schmelly/Mendel90/schmelly/bom/bed_assembly.txt

bed_assembly:
Vitamins:
  4 BD0019     19mm bulldog clip
  1 BED214214  PCB bed 214 x 214
  4 CS03010    M3 cap screw x 10
  1 GL3214202  Glass sheet 214 x 202 x 3
  4 HP0320     Hex pillar M3 x 20
  2 WA3075     Washer M3 x 7 x 0.5

Printed:
