schmelly/Mendel90/schmelly/sheets/y_carriage.dxf

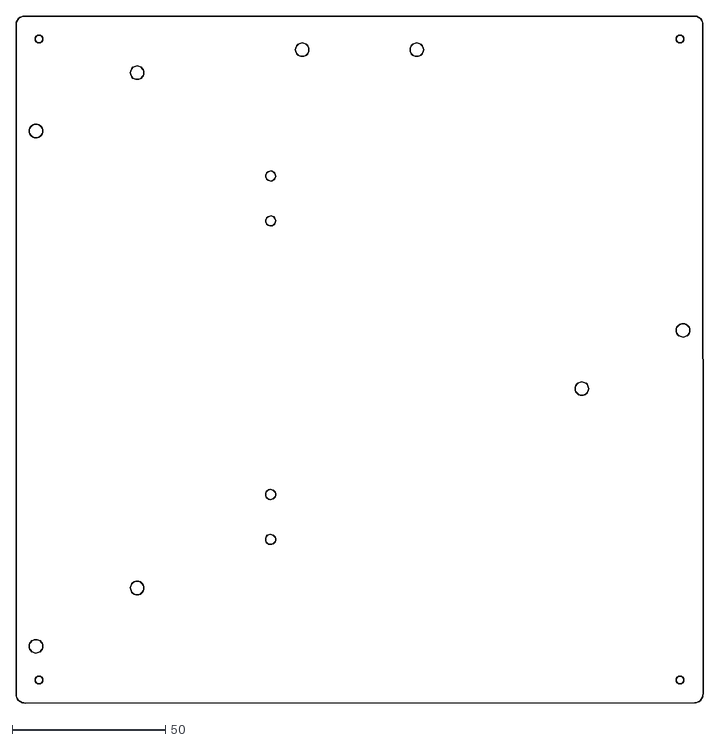
[picture p1: CAD file, 2013-04-06]
schmelly/sheets/y_carriage.dxf
224.0 x 224.0
