schmelly/Mendel90/schmelly/stls/fan_guard.stl

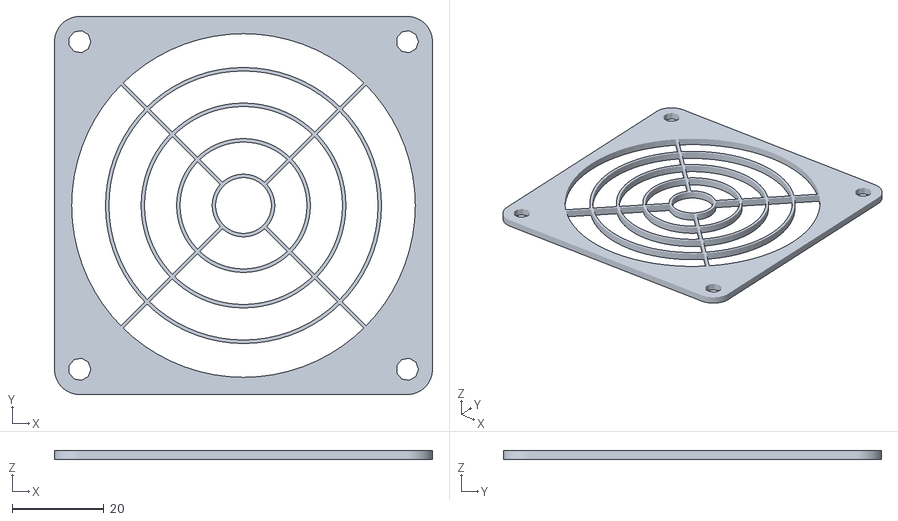
[picture p2: CAD file, 2013-04-06]
schmelly/stls/fan_guard.stl
82.5 x 82.5 x 2.00
