schmelly/Mendel90/schmelly/sheets/frame_gantry.dxf

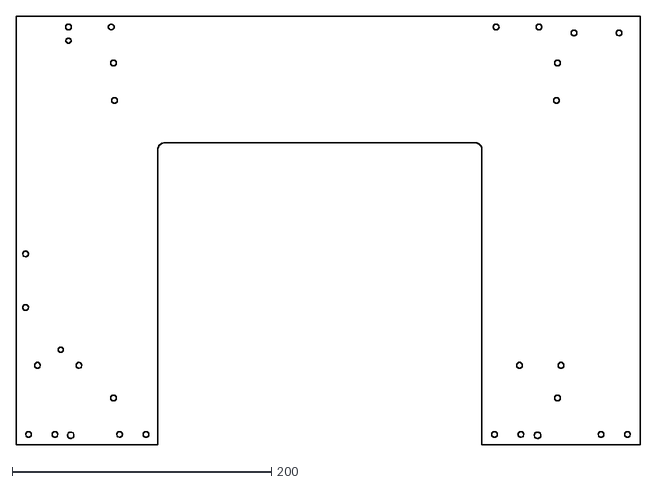
[picture p3: CAD file, 2013-04-06]
schmelly/sheets/frame_gantry.dxf
481.5 x 331.0
