schmelly/Mendel90/schmelly/stls/wades_small_gear.stl

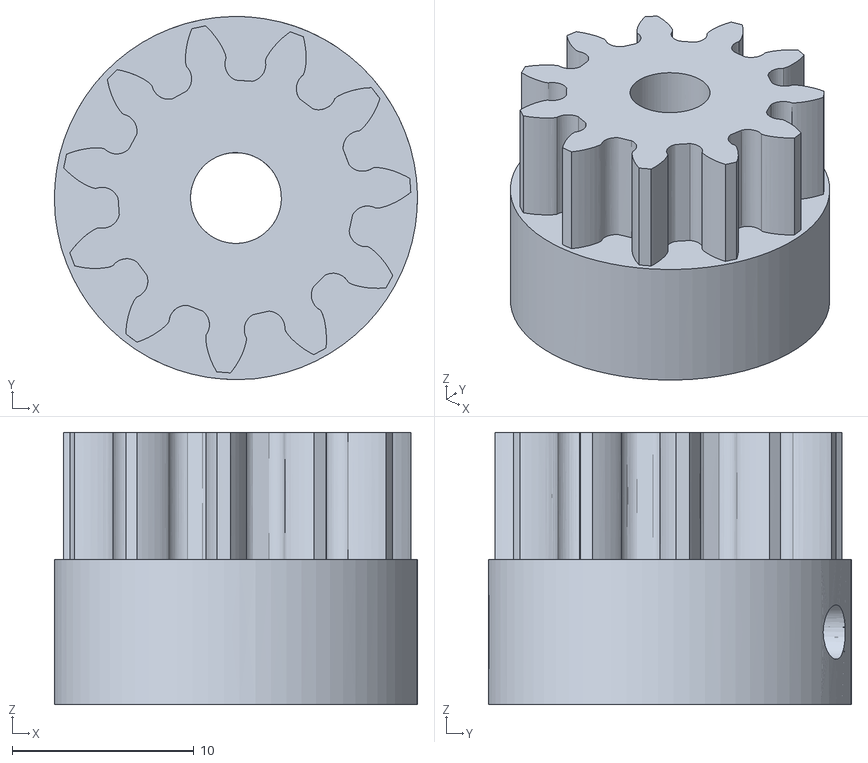
[picture p4: CAD file, 2013-04-06]
schmelly/stls/wades_small_gear.stl
20.0 x 20.0 x 15.0
