schmelly/Mendel90/schmelly/sheets/frame_gantry_and_y_carriage.dxf

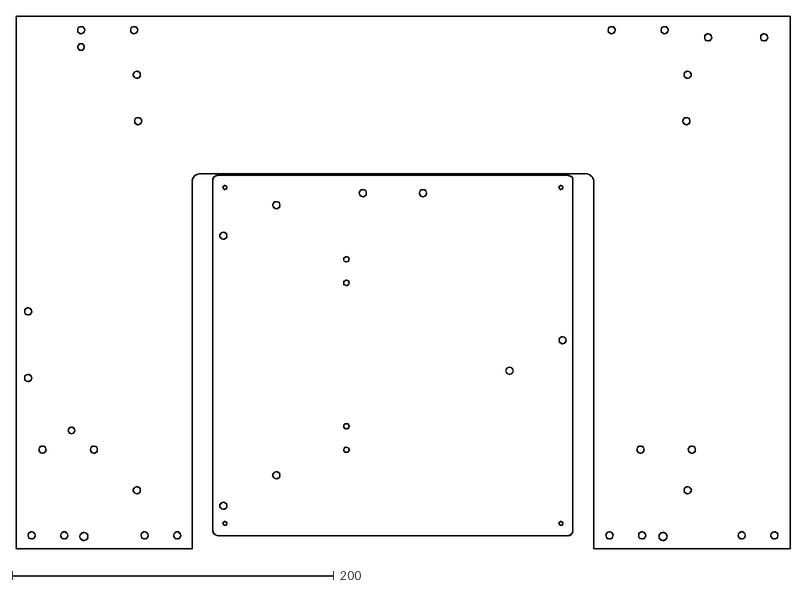
[picture p5: CAD file, 2013-04-06]
schmelly/sheets/frame_gantry_and_y_carriage.dxf
481.5 x 331.0
