schmelly/Mendel90/schmelly/stls/x_motor_bracket.stl

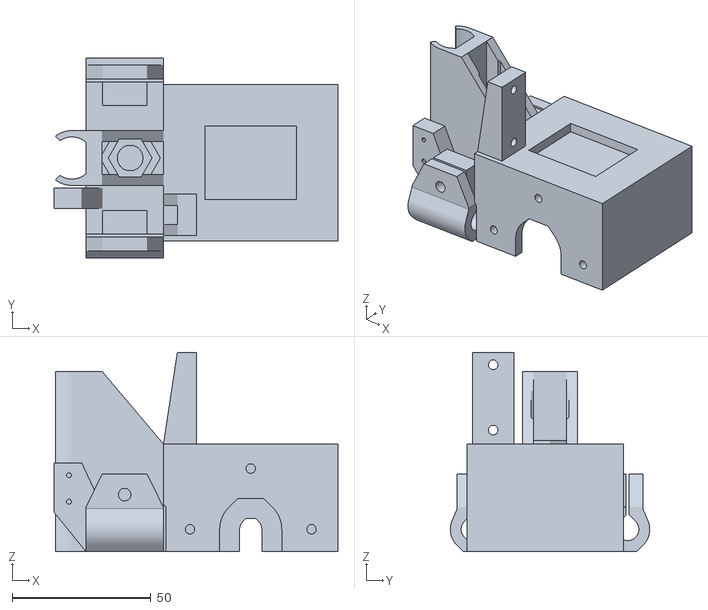
[picture p6: CAD file, 2013-04-06]
schmelly/stls/x_motor_bracket.stl
102.5 x 72.0 x 71.8
