schmelly/Mendel90/schmelly/sheets/frame_base.dxf

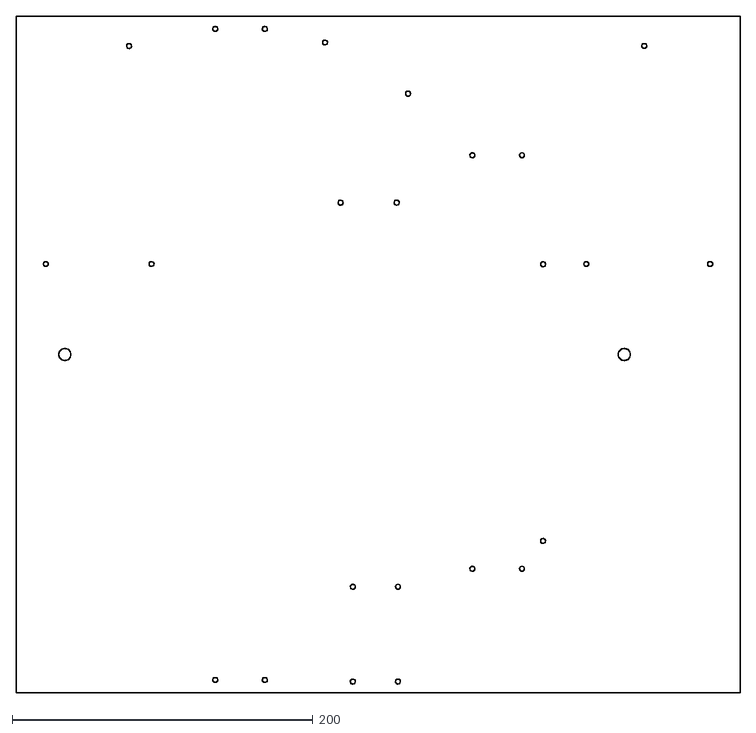
[picture p7: CAD file, 2013-04-06]
schmelly/sheets/frame_base.dxf
481.5 x 450.0
