schmelly/Mendel90/schmelly/stls/x_belt_tensioner.stl

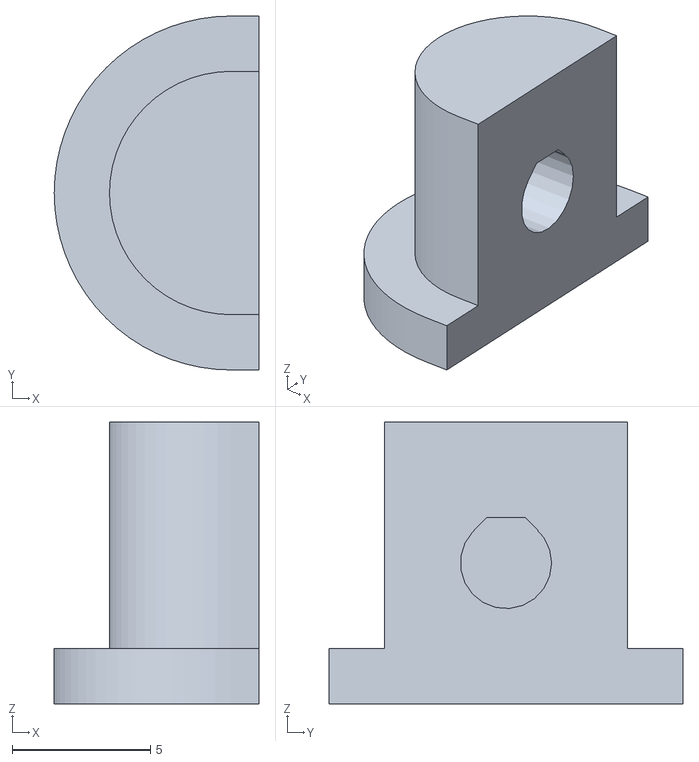
[picture p8: CAD file, 2013-04-06]
schmelly/stls/x_belt_tensioner.stl
7.40 x 12.8 x 10.2
