schmelly/Mendel90/schmelly/sheets/frame_right.dxf

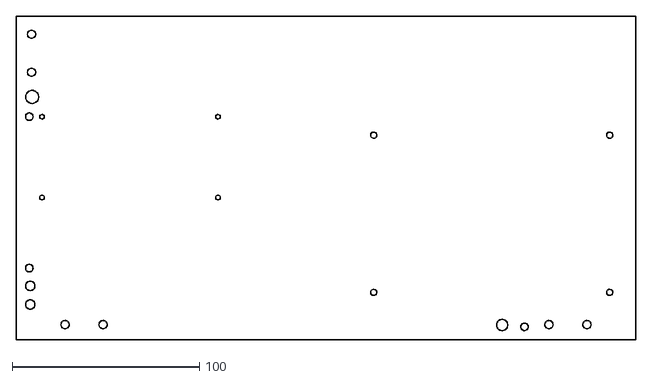
[picture p9: CAD file, 2013-04-06]
schmelly/sheets/frame_right.dxf
331.0 x 173.0
