schmelly/Mendel90/schmelly/stls/ribbon_clamp_20_44.stl

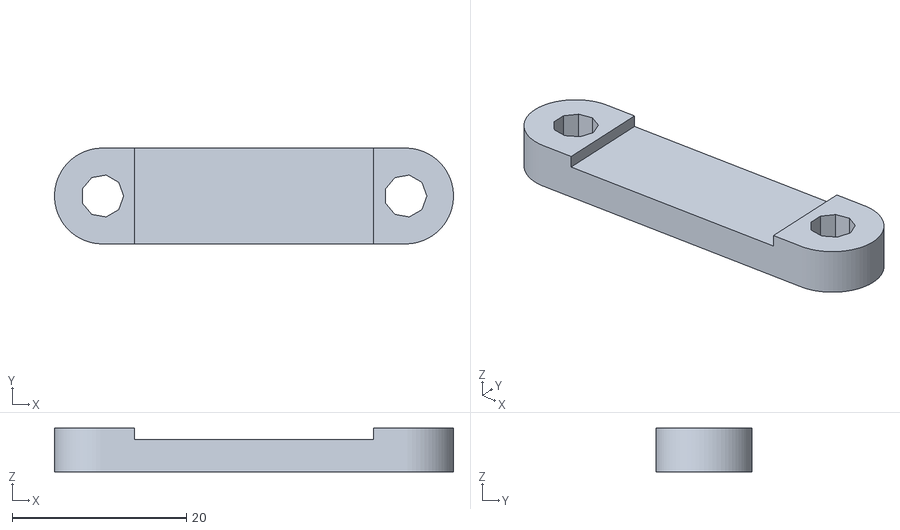
[picture p10: CAD file, 2013-04-06]
schmelly/stls/ribbon_clamp_20_44.stl
45.8 x 11.0 x 5.00
