schmelly/Mendel90/schmelly/sheets/frame_left.dxf

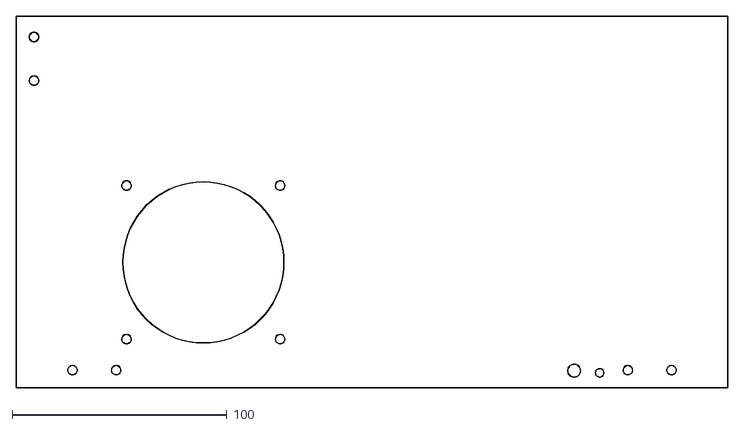
[picture p11: CAD file, 2013-04-06]
schmelly/sheets/frame_left.dxf
331.0 x 173.0
