schmelly/Mendel90/schmelly/stls/y_belt_anchor.stl

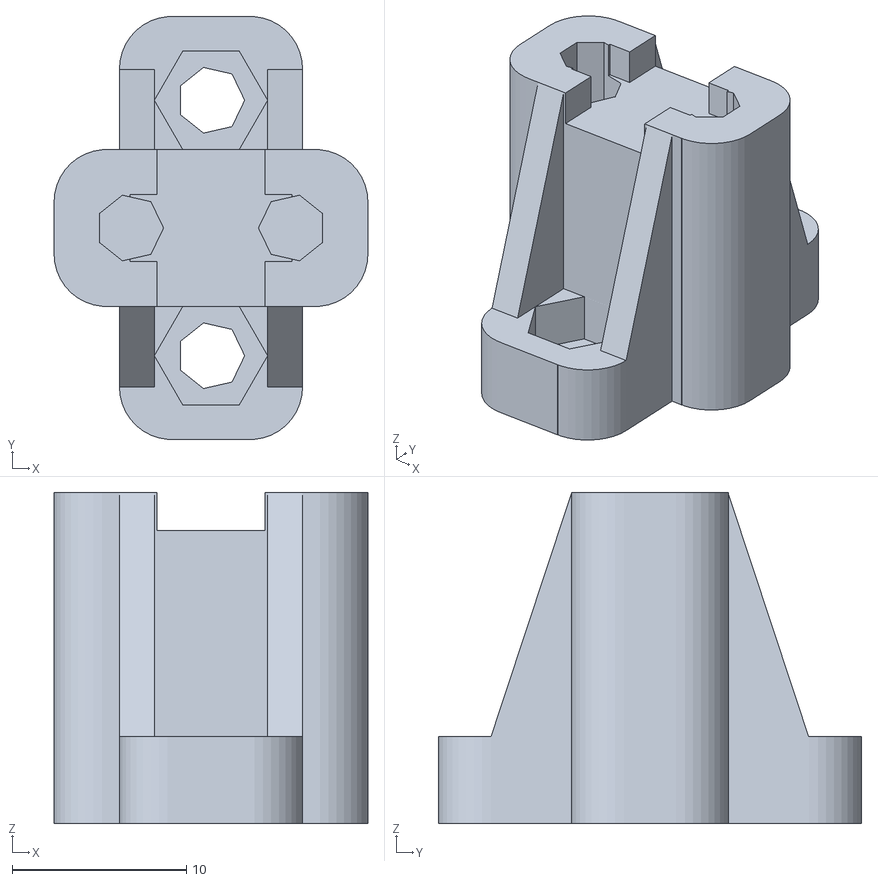
[picture p13: CAD file, 2013-04-06]
schmelly/stls/y_belt_anchor.stl
18.0 x 24.3 x 19.0
