schmelly/Mendel90/schmelly/stls/z_motor_bracket_rhs.stl

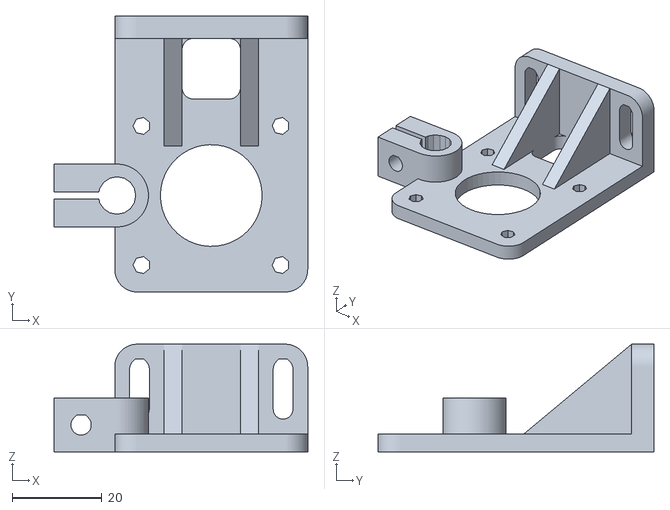
[picture p14: CAD file, 2013-04-06]
schmelly/stls/z_motor_bracket_rhs.stl
56.5 x 61.5 x 24.0
