schmelly/Mendel90/schmelly/stls/cable_clip_AD.stl

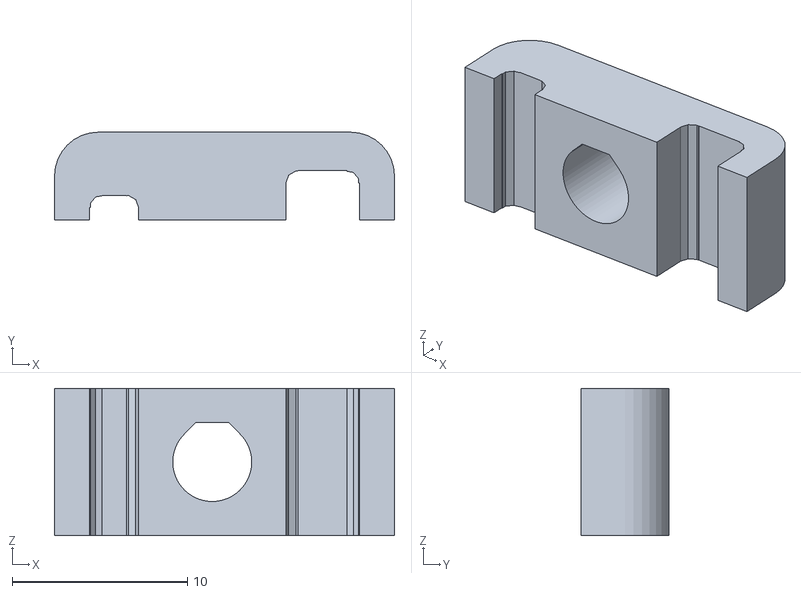
[picture p15: CAD file, 2013-04-06]
schmelly/stls/cable_clip_AD.stl
19.4 x 5.00 x 8.40
