schmelly/Mendel90/schmelly/stls/y_bar_clamp_switch.stl

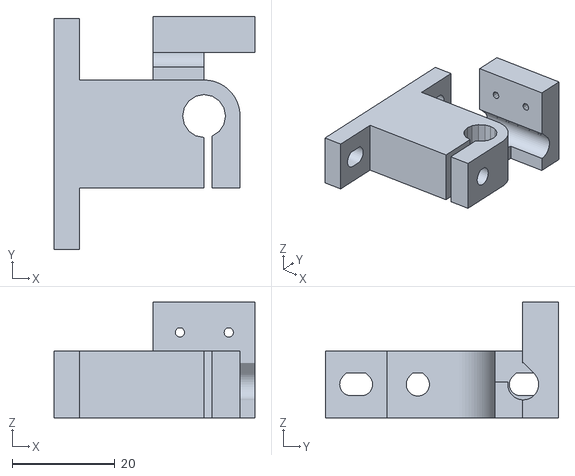
[picture p16: CAD file, 2013-04-06]
schmelly/stls/y_bar_clamp_switch.stl
39.1 x 45.4 x 22.5
