schmelly/Mendel90/schmelly/stls/pcb_spacer.stl

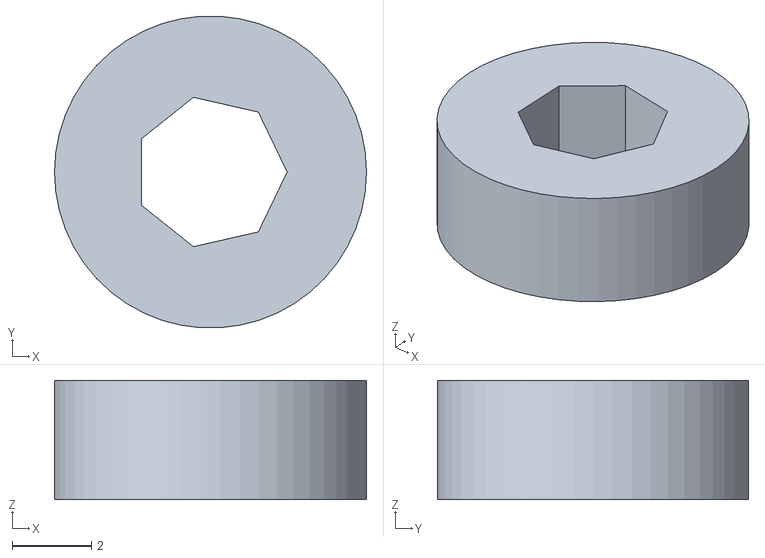
[picture p17: CAD file, 2013-04-06]
schmelly/stls/pcb_spacer.stl
7.86 x 7.85 x 3.00
