schmelly/Mendel90/schmelly/stls/x_carriage.stl

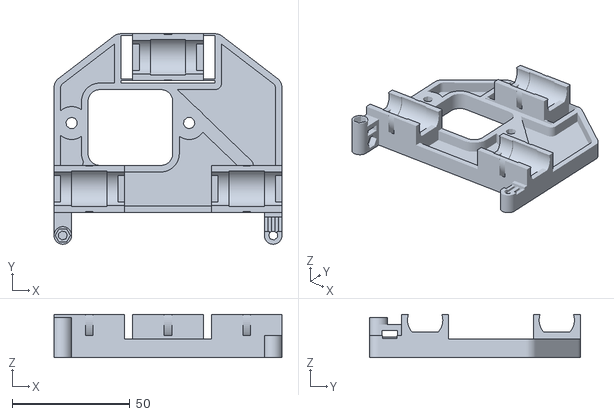
[picture p18: CAD file, 2013-04-06]
schmelly/stls/x_carriage.stl
97.0 x 89.6 x 18.5
