schmelly/Mendel90/schmelly/stls/y_clamps.stl

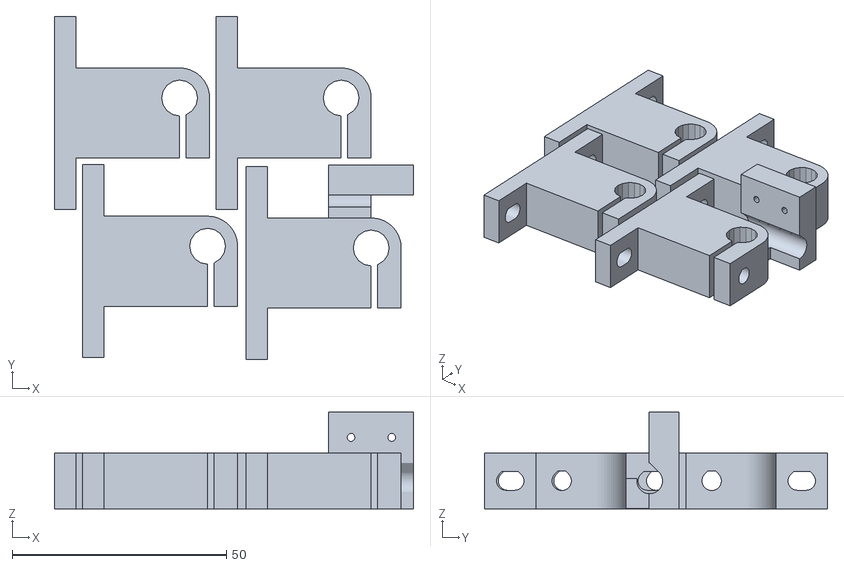
[picture p19: CAD file, 2013-04-06]
schmelly/stls/y_clamps.stl
83.8 x 80.0 x 22.5
