schmelly/Mendel90/schmelly/stls/wades_gear_spacer.stl

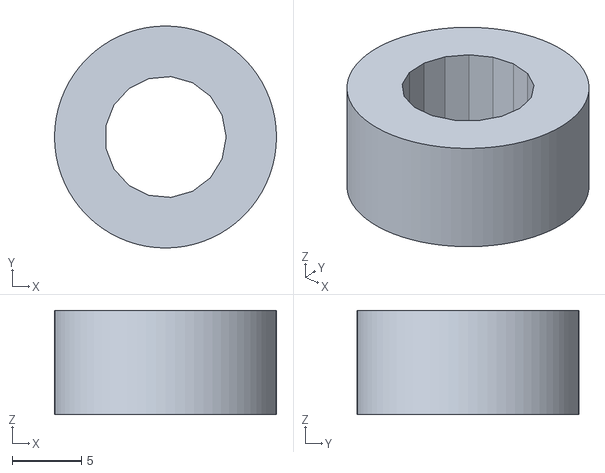
[picture p20: CAD file, 2013-04-06]
schmelly/stls/wades_gear_spacer.stl
16.0 x 16.0 x 7.50
