schmelly/Mendel90/schmelly/stls/ribbon_clamp_12_33.stl

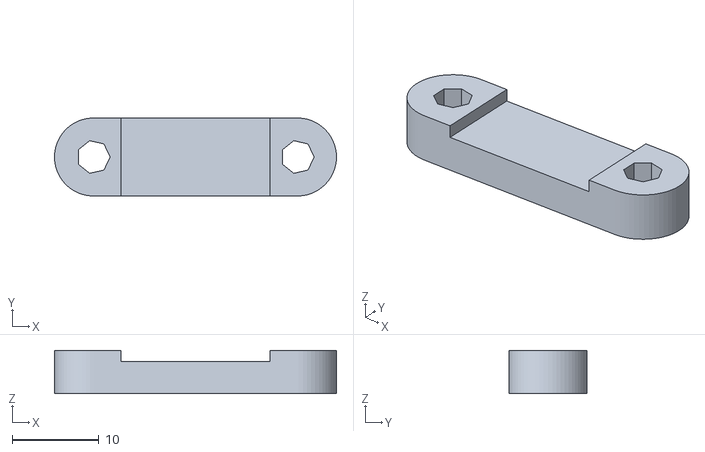
[picture p21: CAD file, 2013-04-06]
schmelly/stls/ribbon_clamp_12_33.stl
32.5 x 9.00 x 5.00
