schmelly/Mendel90/schmelly/stls/d_motor_bracket_lid.stl

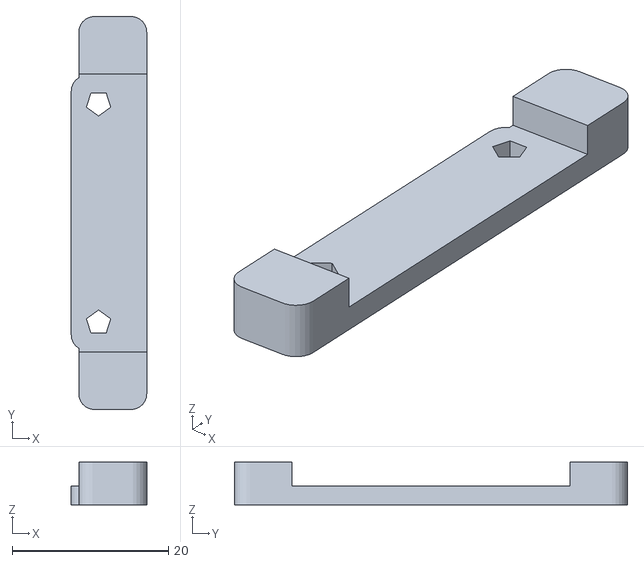
[picture p22: CAD file, 2013-04-06]
schmelly/stls/d_motor_bracket_lid.stl
9.67 x 50.3 x 5.45
