schmelly/Mendel90/schmelly/stls/d_motor_bracket.stl

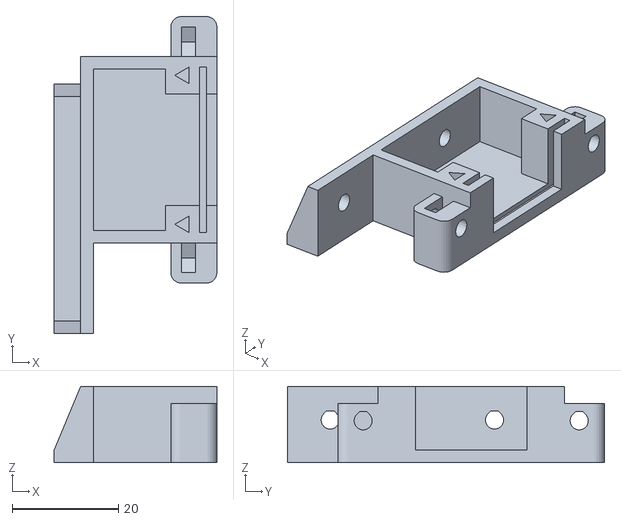
[picture p23: CAD file, 2013-04-06]
schmelly/stls/d_motor_bracket.stl
30.7 x 59.8 x 14.4
