schmelly/Mendel90/schmelly/stls/d_shell.stl

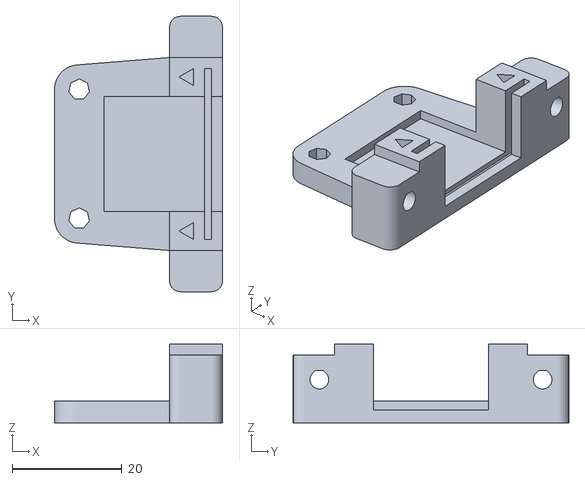
[picture p24: CAD file, 2013-04-06]
schmelly/stls/d_shell.stl
30.7 x 50.3 x 14.4
