schmelly/Mendel90/schmelly/stls/y_bar_clamp.stl

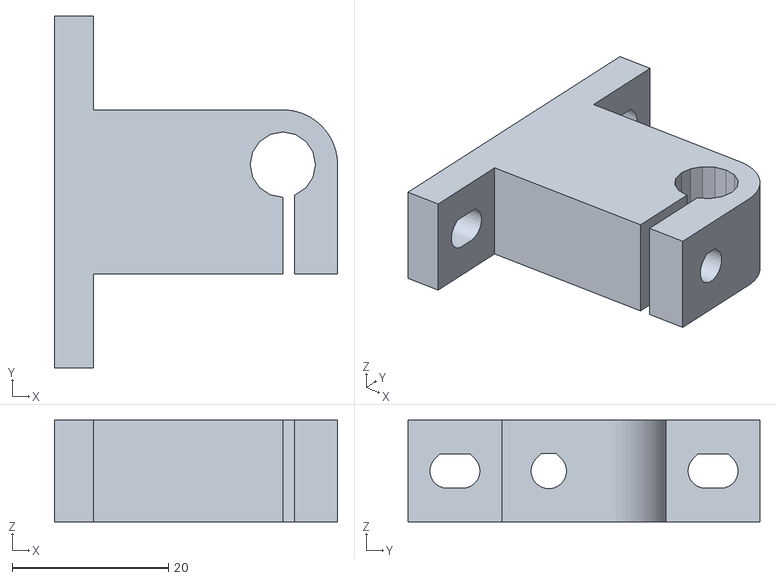
[picture p25: CAD file, 2013-04-06]
schmelly/stls/y_bar_clamp.stl
36.2 x 45.0 x 13.0
