schmelly/Mendel90/schmelly/stls/y_bearing_mount.stl

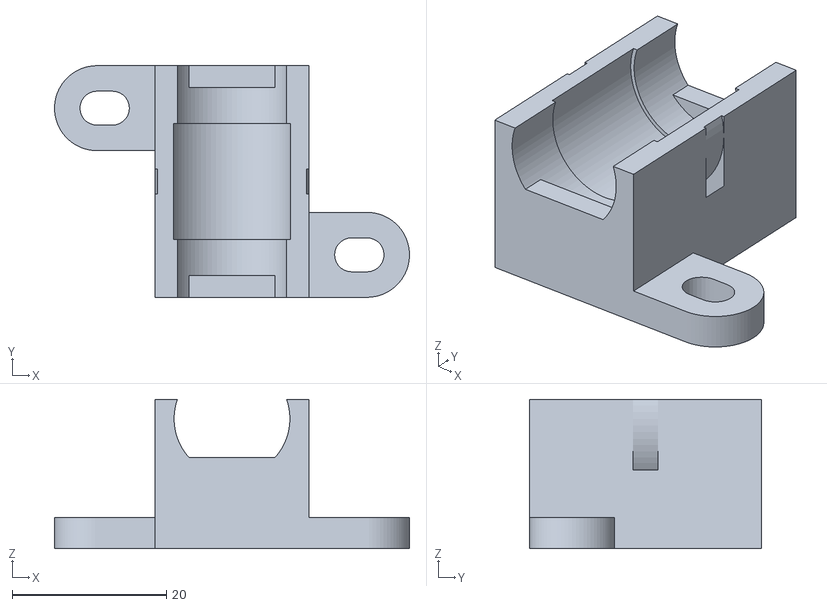
[picture p26: CAD file, 2013-04-06]
schmelly/stls/y_bearing_mount.stl
46.0 x 30.0 x 19.3
