schmelly/Mendel90/schmelly/stls/x_idler_bracket.stl

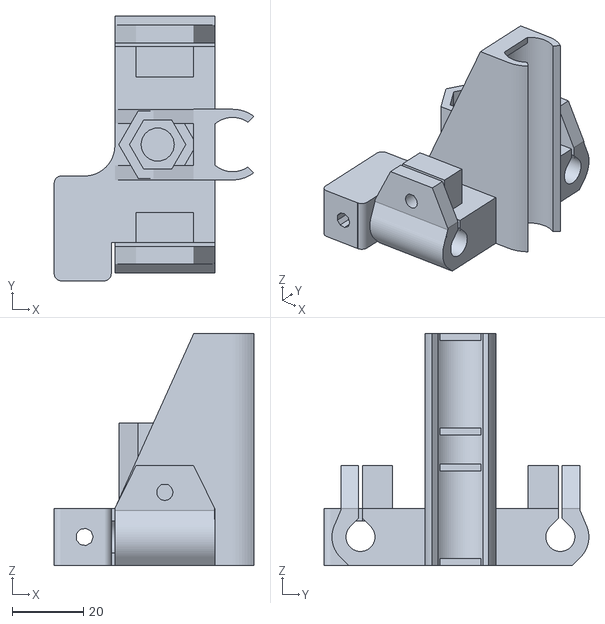
[picture p27: CAD file, 2013-04-06]
schmelly/stls/x_idler_bracket.stl
55.9 x 74.2 x 65.0
