schmelly/Mendel90/schmelly/stls/x_belt_clamp.stl

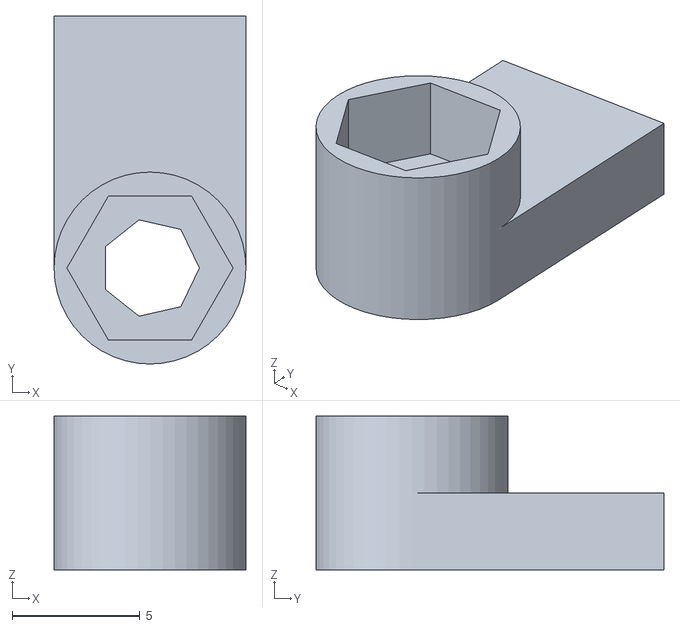
[picture p28: CAD file, 2013-04-06]
schmelly/stls/x_belt_clamp.stl
7.50 x 13.6 x 6.00
