schmelly/Mendel90/schmelly/stls/z_limit_switch_bracket.stl

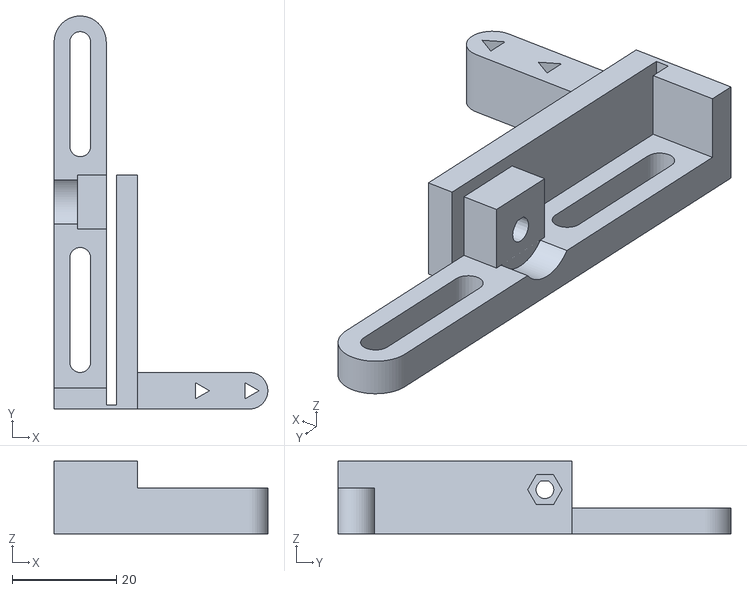
[picture p29: CAD file, 2013-04-06]
schmelly/stls/z_limit_switch_bracket.stl
41.0 x 75.4 x 14.0
