schmelly/Mendel90/schmelly/stls/y_belt_clip_toothed.stl

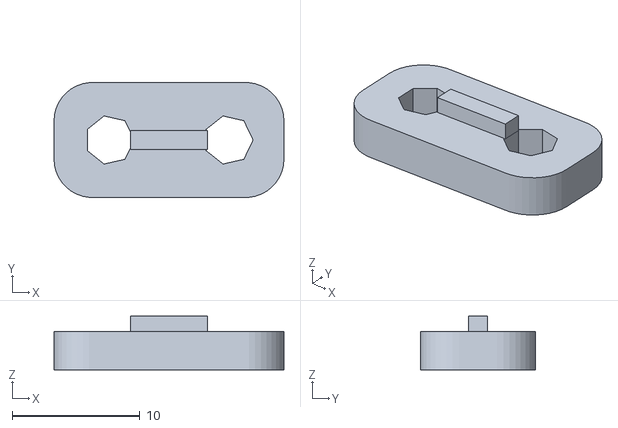
[picture p30: CAD file, 2013-04-06]
schmelly/stls/y_belt_clip_toothed.stl
18.0 x 9.00 x 4.19
