schmelly/Mendel90/schmelly/stls/pulley.stl

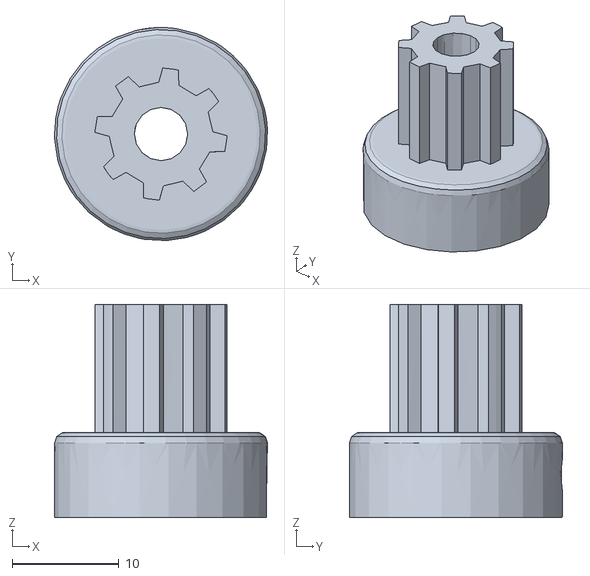
[picture p31: CAD file, 2013-04-06]
schmelly/stls/pulley.stl
20.0 x 20.0 x 20.0
