schmelly/Mendel90/schmelly/stls/y_motor_bracket.stl

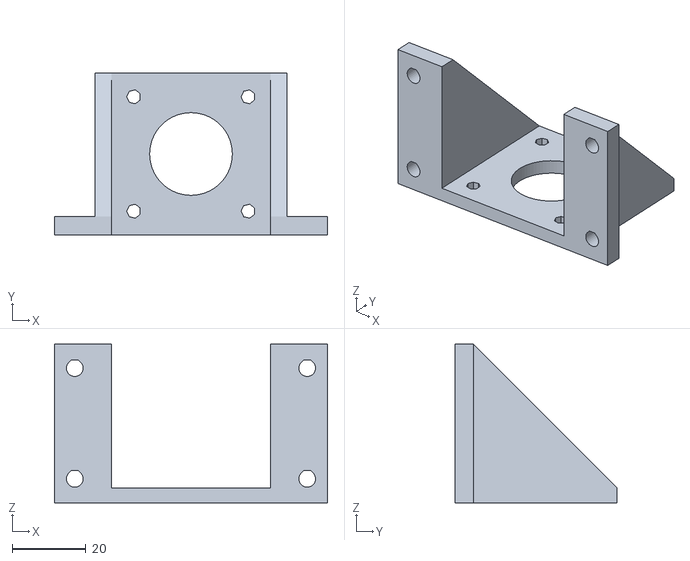
[picture p32: CAD file, 2013-04-06]
schmelly/stls/y_motor_bracket.stl
74.0 x 44.0 x 43.0
