schmelly/Mendel90/schmelly/stls/ribbon_clamp_20_33.stl

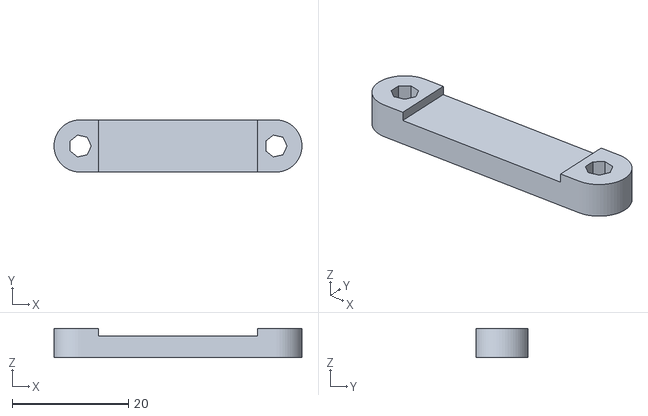
[picture p33: CAD file, 2013-04-06]
schmelly/stls/ribbon_clamp_20_33.stl
42.7 x 9.00 x 5.00
