schmelly/Mendel90/schmelly/stls/cable_clip_AB.stl

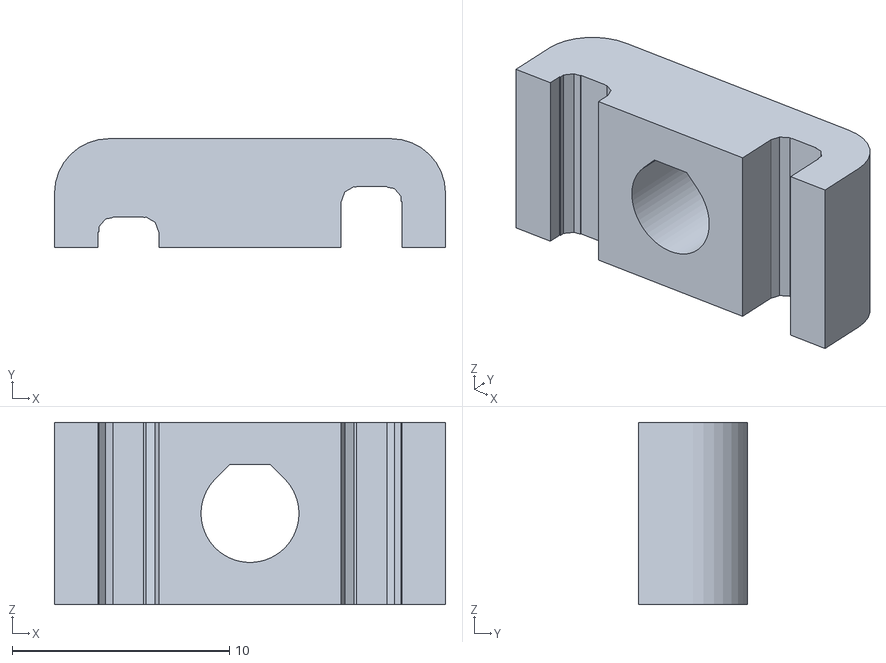
[picture p34: CAD file, 2013-04-06]
schmelly/stls/cable_clip_AB.stl
18.0 x 5.00 x 8.40
