schmelly/Mendel90/schmelly/stls/z_clamps.stl

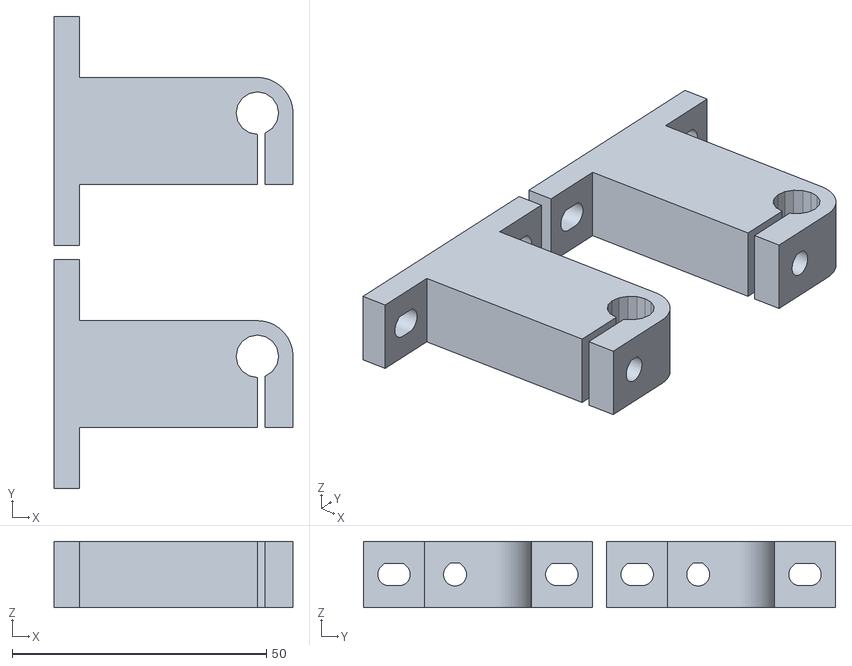
[picture p35: CAD file, 2013-04-06]
schmelly/stls/z_clamps.stl
47.0 x 92.8 x 13.0
