schmelly/Mendel90/schmelly/stls/d_shell_lid.stl

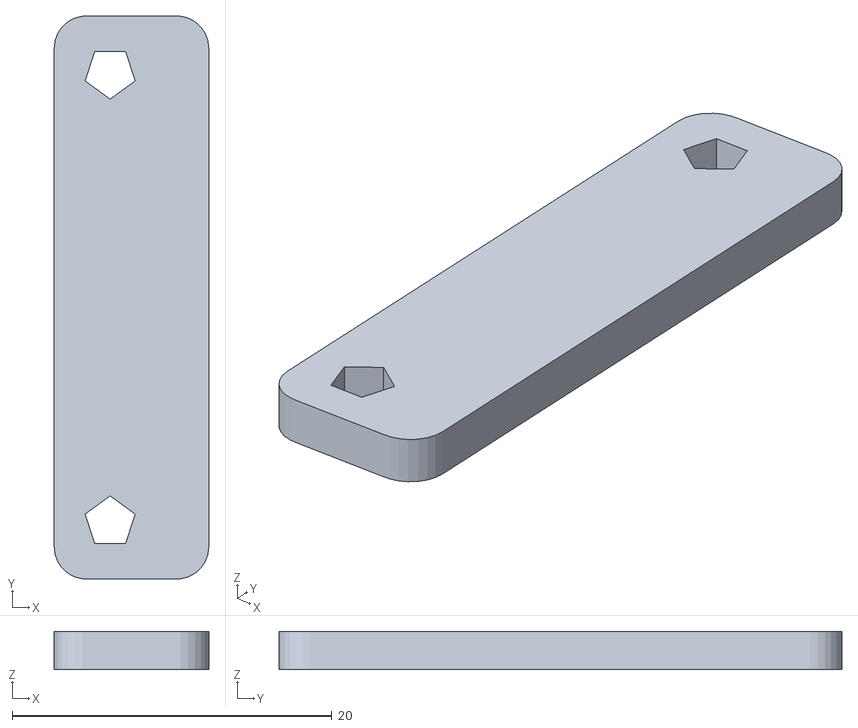
[picture p36: CAD file, 2013-04-06]
schmelly/stls/d_shell_lid.stl
9.67 x 35.2 x 2.40
