schmelly/Mendel90/schmelly/stls/wades_big_gear.stl

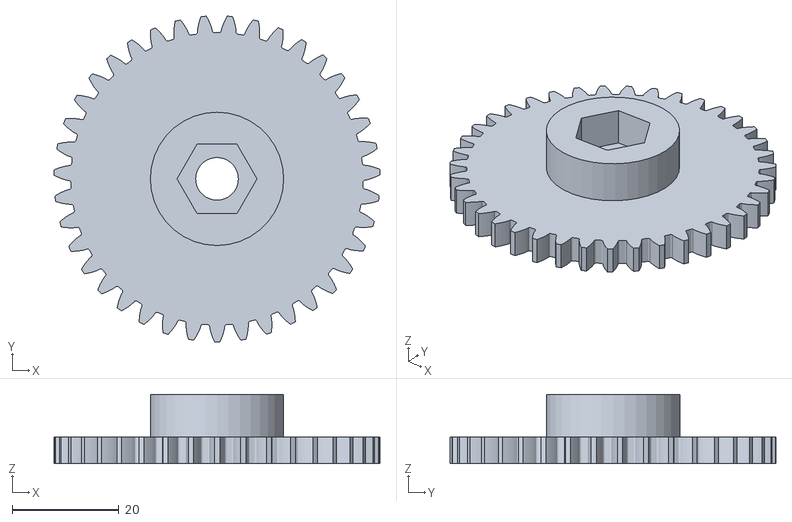
[picture p37: CAD file, 2013-04-06]
schmelly/stls/wades_big_gear.stl
61.1 x 61.1 x 13.0
