schmelly/Mendel90/schmelly/stls/y_belt_clip.stl

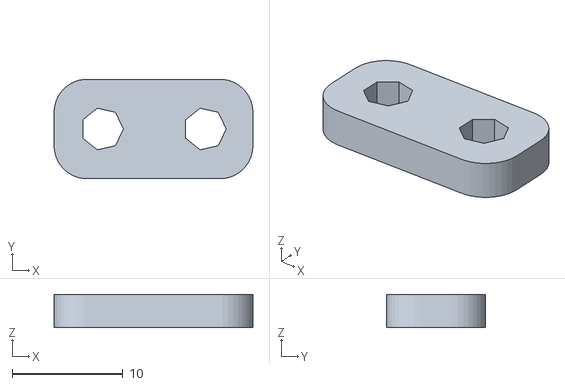
[picture p38: CAD file, 2013-04-06]
schmelly/stls/y_belt_clip.stl
18.0 x 9.00 x 3.00
