schmelly/Mendel90/schmelly/stls/y_idler_bracket.stl

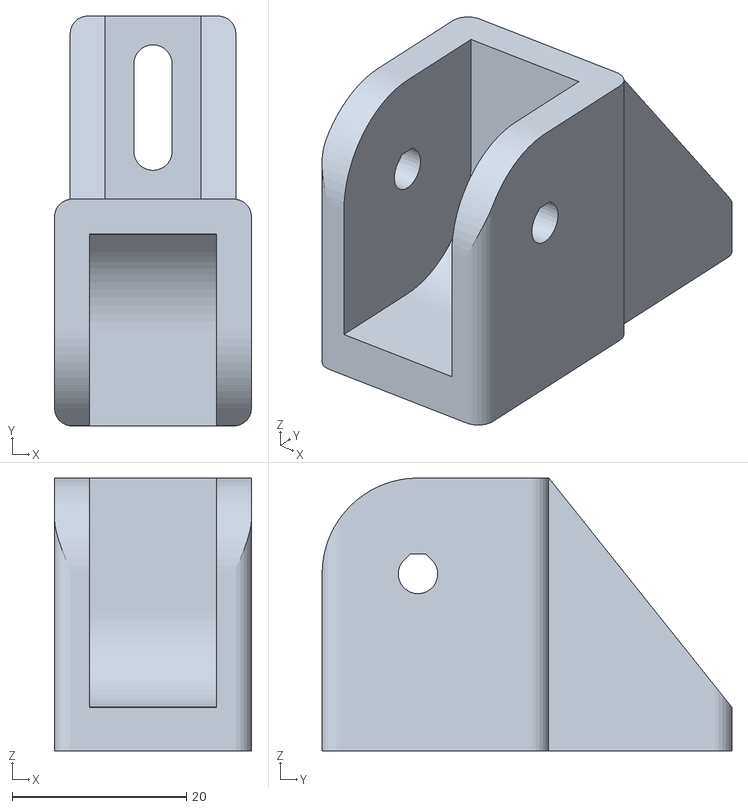
[picture p39: CAD file, 2013-04-06]
schmelly/stls/y_idler_bracket.stl
22.6 x 47.0 x 31.3
