schmelly/Mendel90/schmelly/stls/y_bearing_mount_switch.stl

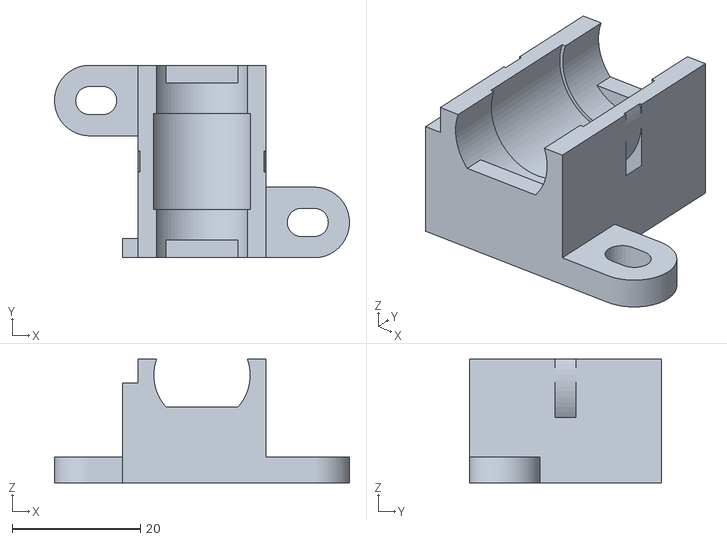
[picture p40: CAD file, 2013-04-06]
schmelly/stls/y_bearing_mount_switch.stl
46.0 x 30.0 x 19.3
