schmelly/Mendel90/schmelly/stls/wades_idler_block.stl

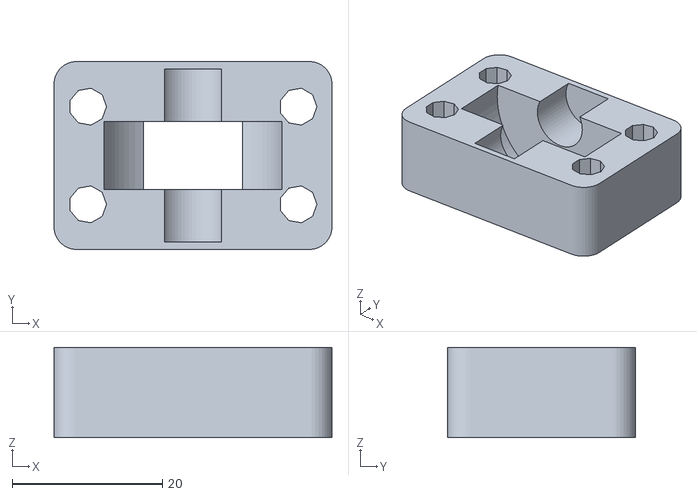
[picture p41: CAD file, 2013-04-06]
schmelly/stls/wades_idler_block.stl
37.0 x 25.0 x 12.0
