schmelly/Mendel90/schmelly/stls/wades_block.stl

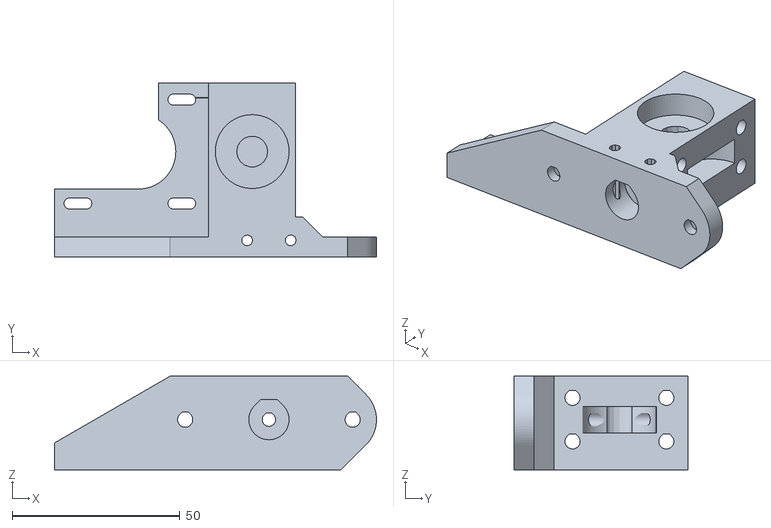
[picture p42: CAD file, 2013-04-06]
schmelly/stls/wades_block.stl
96.1 x 52.0 x 28.0
