schmelly/Mendel90/schmelly/stls/ribbon_clamp_22_44.stl

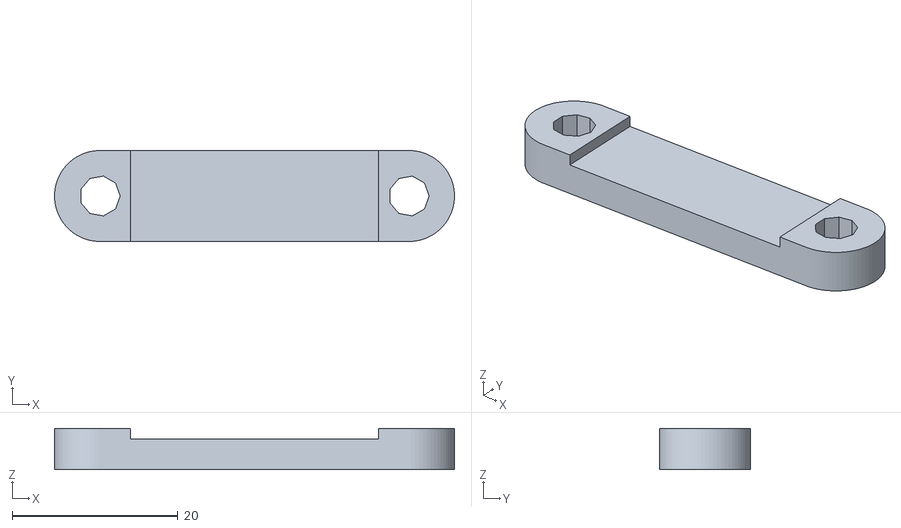
[picture p43: CAD file, 2013-04-06]
schmelly/stls/ribbon_clamp_22_44.stl
48.3 x 11.0 x 5.00
