schmelly/Mendel90/schmelly/stls/fixing_block.stl

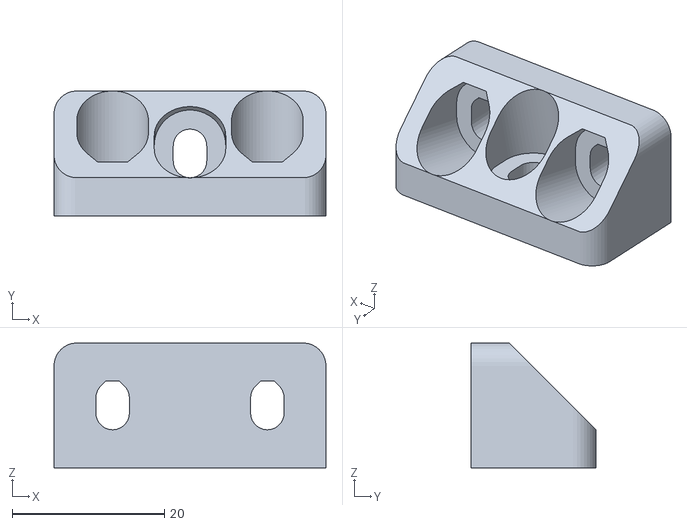
[picture p44: CAD file, 2013-04-06]
schmelly/stls/fixing_block.stl
35.7 x 16.4 x 16.4
