schmelly/Mendel90/schmelly/stls/cable_clip_CA.stl

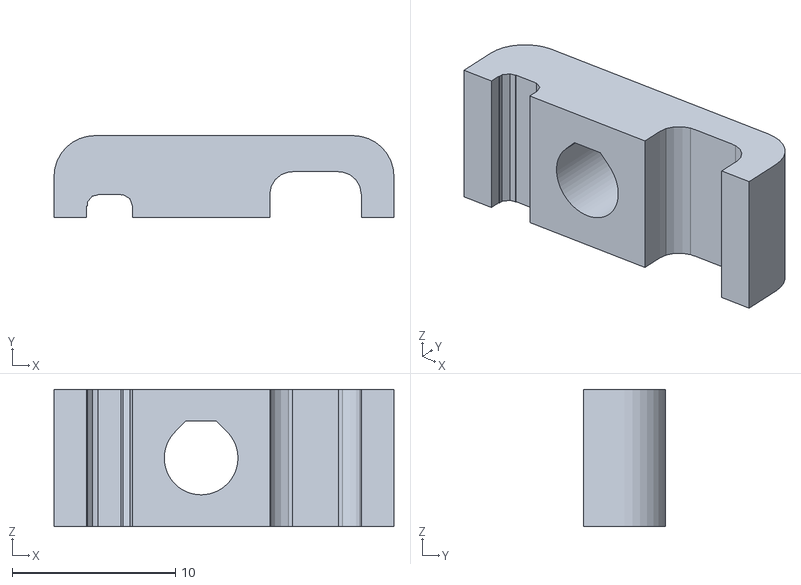
[picture p45: CAD file, 2013-04-06]
schmelly/stls/cable_clip_CA.stl
20.8 x 5.00 x 8.40
