schmelly/Mendel90/schmelly/stls/z_bar_clamp_switch.stl

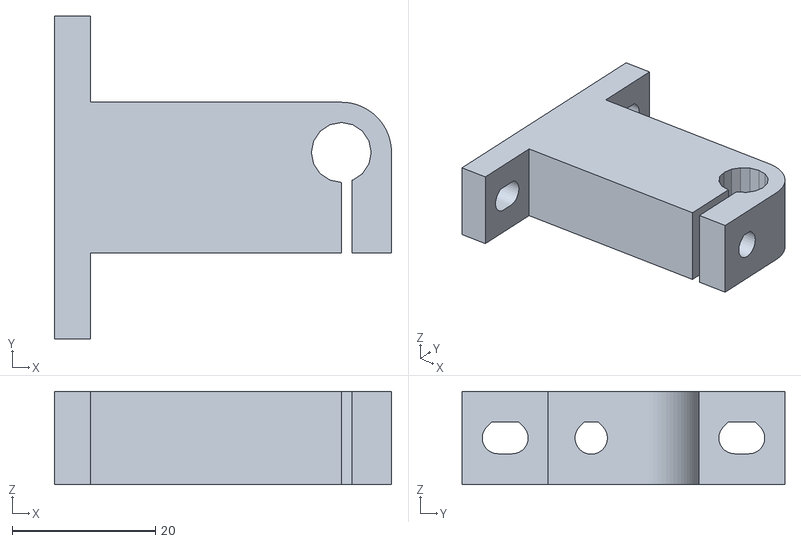
[picture p46: CAD file, 2013-04-06]
schmelly/stls/z_bar_clamp_switch.stl
47.0 x 45.0 x 13.0
