schmelly/Mendel90/schmelly/stls/z_coupling.stl

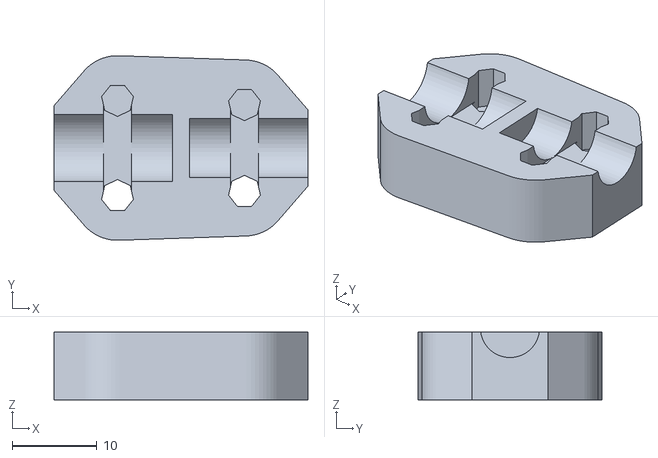
[picture p47: CAD file, 2013-04-06]
schmelly/stls/z_coupling.stl
30.0 x 21.8 x 8.00
