schmelly/Mendel90/schmelly/stls/x_belt_grip.stl

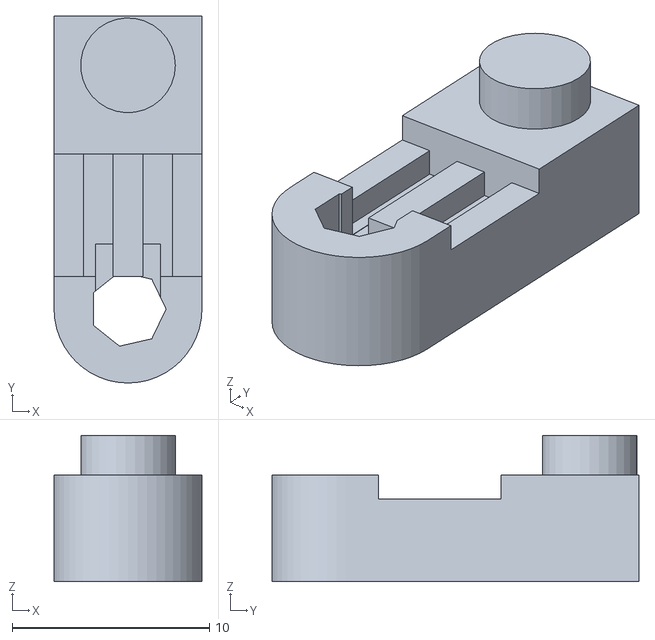
[picture p48: CAD file, 2013-04-06]
schmelly/stls/x_belt_grip.stl
7.50 x 18.6 x 7.41
