schmelly/Mendel90/scad/conf/machine.scad

include <schmelly_config.scad>
