schmelly/Mendel90/scad/stl.scad

use <scad/z-screw_pointer.scad>
z_screw_pointer_stl();
