schmelly/Mendel90/schmelly/sheets/frame_base_dxf.scad

use <scad/main.scad>
frame_base_dxf();
