schmelly/Mendel90/schmelly/sheets/frame_gantry_and_y_carriage_dxf.scad

use <scad/main.scad>
frame_gantry_and_y_carriage_dxf();
