schmelly/Mendel90/schmelly/sheets/frame_gantry_dxf.scad

use <scad/main.scad>
frame_gantry_dxf();
