schmelly/Mendel90/schmelly/sheets/frame_left_dxf.scad

use <scad/main.scad>
frame_left_dxf();
