schmelly/Mendel90/schmelly/sheets/frame_right_dxf.scad

use <scad/main.scad>
frame_right_dxf();
