schmelly/Mendel90/schmelly/sheets/y_carriage_dxf.scad

use <scad/main.scad>
y_carriage_dxf();
