schmelly/Mendel90/(list of files, cad)

Other CAD files:
schmelly/stls/y_belt_anchor_toothed.stl
schmelly/stls/z_motor_bracket_lhs.stl
schmelly/stls/z_screw_pointer.stl
