schmelly/Mendel90/schmelly/bom/bed_fan_assembly.txt

bed_fan_assembly:
Vitamins:
  4 CS04025    M4 cap screw x 25
  1 FAN8038    Fan 80 x 38
  4 NYLOCM4    Nyloc nut M4
  4 WA4099     Washer M4 x 9 x 0.9

Printed:
  1 fan_guard.stl
