schmelly/Mendel90/schmelly/bom/D_connector_assembly.txt

D_connector_assembly:
Vitamins:
  2 CS03016    M3 cap screw x 16
  2 CS03020    M3 cap screw x 20
  2 CS03045    M3 cap screw x 45
  1 DTYPEP9    9 way D plug
  1 DTYPES9    9 way D socket
  2 NUTM3      Nut M3
  2 NYLOCM3    Nyloc nut M3
  4 PSW0213    No2 pan wood screw x 13
  4 WA2555     Washer M2.5 x 5 x 0.5
  8 WA3075     Washer M3 x 7 x 0.5

Printed:
  1 d_motor_bracket.stl
  1 d_motor_bracket_lid.stl
  1 d_shell.stl
  1 d_shell_lid.stl
  1 ribbon_clamp_12_33.stl
