schmelly/Mendel90/schmelly/bom/x_axis_assembly.txt

x_axis_assembly:
Vitamins:
  1 BT36874    Belt T3 x 6 x 874
  1 PP517386   Polypropylene strip 386mm x 17mm x 0.5mm
  2 RD8396     Smooth rod 8 x 396

Printed:

Sub-assemblies:
  1 x_carriage_assembly
