schmelly/Mendel90/schmelly/bom/x_carriage_assembly.txt

x_carriage_assembly:
Vitamins:
  1 CS03020    M3 cap screw x 20
  2 CS03025    M3 cap screw x 25
  3 LM8UU      LM8UU linear bearing
  1 NUTM3      Nut M3
  2 NYLOCM3    Nyloc nut M3
  2 WA3075     Washer M3 x 7 x 0.5
  2 WING04     Wingnut M4
  3 ZT0087     Ziptie 87

Printed:
  1 x_belt_clamp.stl
  1 x_belt_grip.stl
  1 x_belt_tensioner.stl
  1 x_carriage.stl

Sub-assemblies:
  1 wades_assembly
