schmelly/Mendel90/schmelly/bom/x_idler_assembly.txt

x_idler_assembly:
Vitamins:
  1 BB624      Ball bearing 624 4 x 13 x 5
  1 CS04040    M4 cap screw x 40
  2 HX04016    M4 hex screw x 16
  2 LM8UU      LM8UU linear bearing
  1 NUTM8      Nut M8
  3 NYLOCM4    Nyloc nut M4
  4 WA4099     Washer M4 x 9 x 0.9
  2 WA502014   Washer M5 x 20 x 1.4

Printed:
  1 x_idler_bracket.stl
