schmelly/Mendel90/schmelly/bom/y_carriage_assembly.txt

y_carriage_assembly:
Vitamins:
  8 CS03016    M3 cap screw x 16
  6 CS04016    M4 cap screw x 16
  2 CS04025    M4 cap screw x 25
  1 DB2224224  Dibond sheet 224 x 224 x 2
  3 LM8UU      LM8UU linear bearing
  8 NYLOCM3    Nyloc nut M3
  8 NYLOCM4    Nyloc nut M4
  8 WA3075     Washer M3 x 7 x 0.5
 16 WA4099     Washer M4 x 9 x 0.9
  3 ZT0087     Ziptie 87

Printed:
  2 ribbon_clamp_22_44.stl
  2 y_bearing_mount.stl
  1 y_bearing_mount_switch.stl
  1 y_belt_anchor.stl
  1 y_belt_anchor_toothed.stl
  1 y_belt_clip.stl
  1 y_belt_clip_toothed.stl

Sub-assemblies:
  1 bed_assembly
