schmelly/Mendel90/schmelly/bom/y_idler_assembly.txt

y_idler_assembly:
Vitamins:
  2 BB624      Ball bearing 624 4 x 13 x 5
  1 CS04040    M4 cap screw x 40
  1 NYLOCM4    Nyloc nut M4
  1 PS04016    M4 pan screw x 16
  5 WA4099     Washer M4 x 9 x 0.9
  2 WA502014   Washer M5 x 20 x 1.4
  1 WS4099     Star washer M4 x 9 x 0.9

Printed:
  1 y_idler_bracket.stl
