schmelly/Mendel90/schmelly/bom/y_motor_assembly.txt

y_motor_assembly:
Vitamins:
  1 GB0306     M3 grub screw x 6
  1 NEMA17475  NEMA17 x 47.5 stepper motor
  1 NUTM3      Nut M3
  4 PS0308     M3 pan screw x 8
  4 PS04016    M4 pan screw x 16
  4 WA3075     Washer M3 x 7 x 0.5
  4 WA4099     Washer M4 x 9 x 0.9
  4 WS3075     Star washer M3 x 7 x 0.5
  4 WS4099     Star washer M4 x 9 x 0.9

Printed:
  1 pulley.stl
  1 y_motor_bracket.stl
