schmelly/Mendel90/schmelly/bom/z_limit_switch_assembly.txt

z_limit_switch_assembly:
Vitamins:
  2 CS04025    M4 cap screw x 25
  1 HX03016    M3 hex screw x 16
  1 NYLOCM3    Nyloc nut M3
  2 NYLOCM4    Nyloc nut M4
  2 PSW0213    No2 pan wood screw x 13
  1 SMMICRO    Microswitch
  2 WA2555     Washer M2.5 x 5 x 0.5
  1 WA3075     Washer M3 x 7 x 0.5
  4 WA4099     Washer M4 x 9 x 0.9
  2 WR301015   Rubber washer M3 x 10 x 1.5

Printed:
  1 z_limit_switch_bracket.stl
