schmelly/Mendel90/schmelly/sheets/y_carriage.pdf

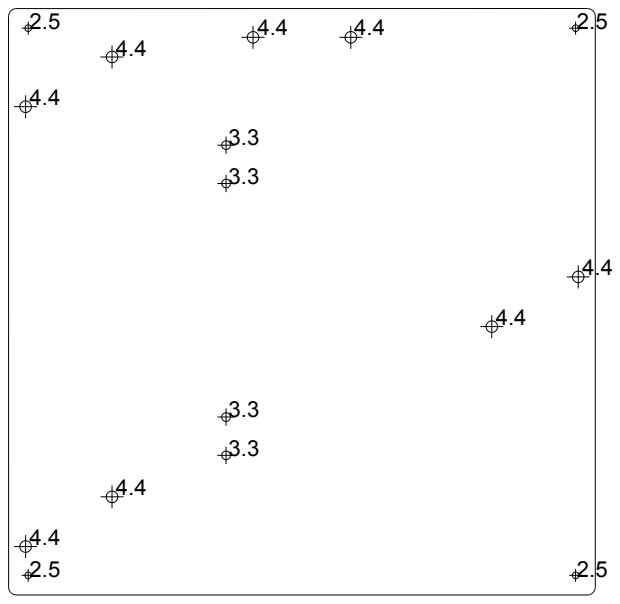
[picture p49: page 1]
