schmelly/Mendel90/(commit log)

2013-04-06 added my machine configuration
    [belts.scad, cable_clip_AB.stl, cable_clip_AD.stl, cable_clip_CA.stl, config.scad, d_motor_bracket.stl, d_motor_bracket_lid.stl, d_shell.stl]
2013-04-28 enabled exploded view
    [config.scad, stl.scad]
